Therapye/winter-practice/STL files/petal attachment.stl

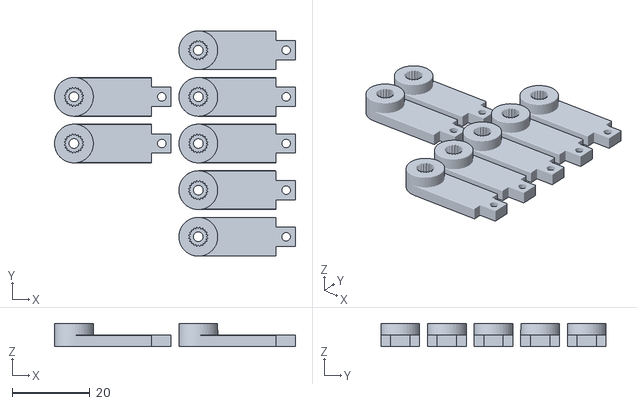
[picture p1: CAD file, 2026-03-15]
STL files/petal attachment.stl
62.0 x 58.0 x 6.00
