Therapye/winter-practice/STL files/petals.stl

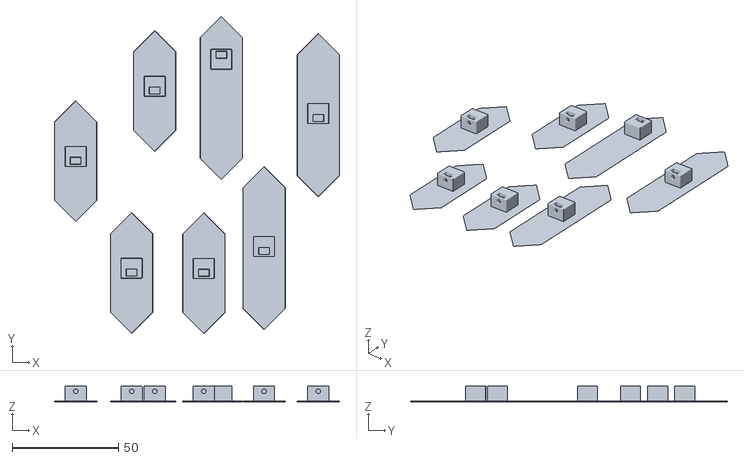
[picture p2: CAD file, 2026-03-15]
STL files/petals.stl
134.3 x 149.4 x 7.50
