Therapye/winter-practice/STL files/cover.stl

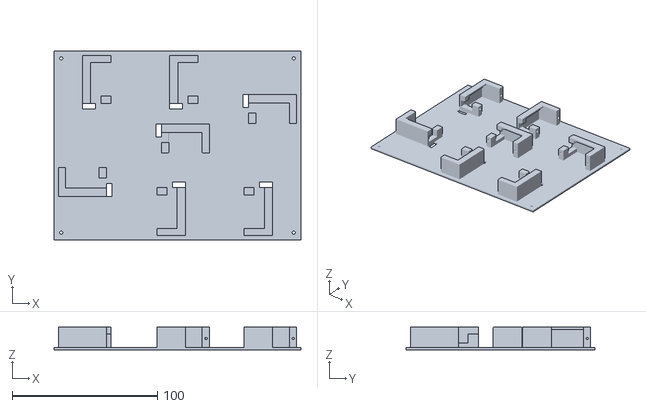
[picture p3: CAD file, 2026-03-15]
STL files/cover.stl
170.0 x 130.0 x 15.5
