Therapye/winter-practice/STL files/button cover.stl

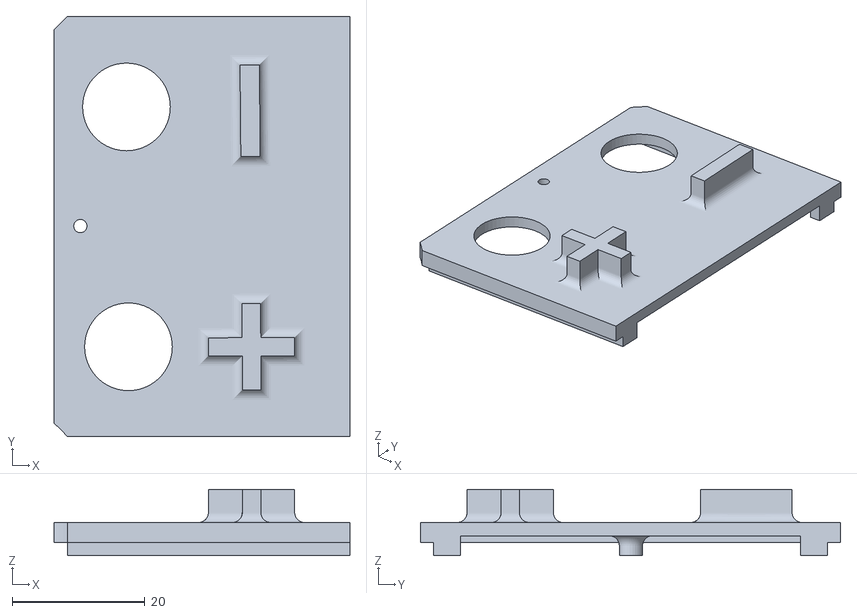
[picture p4: CAD file, 2026-03-15]
STL files/button cover.stl
44.6 x 63.3 x 10.0
