Therapye/winter-practice/STL files/bottom.stl

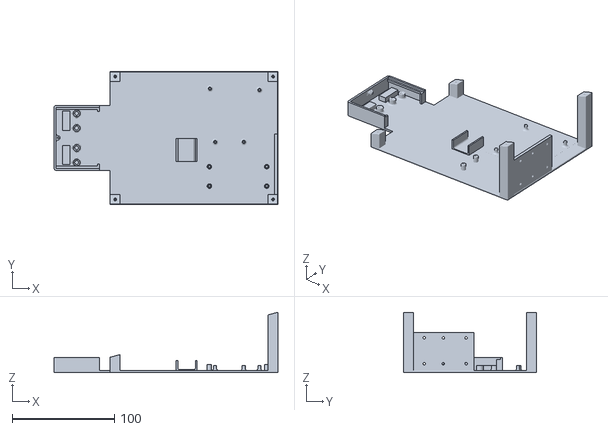
[picture p5: CAD file, 2026-03-15]
STL files/bottom.stl
218.8 x 130.0 x 59.0
