Therapye/winter-practice/Schematics/circuit for practise.kicad_sch

## KiCad design Schematics/circuit for practise.kicad_sch (2026-03-15)

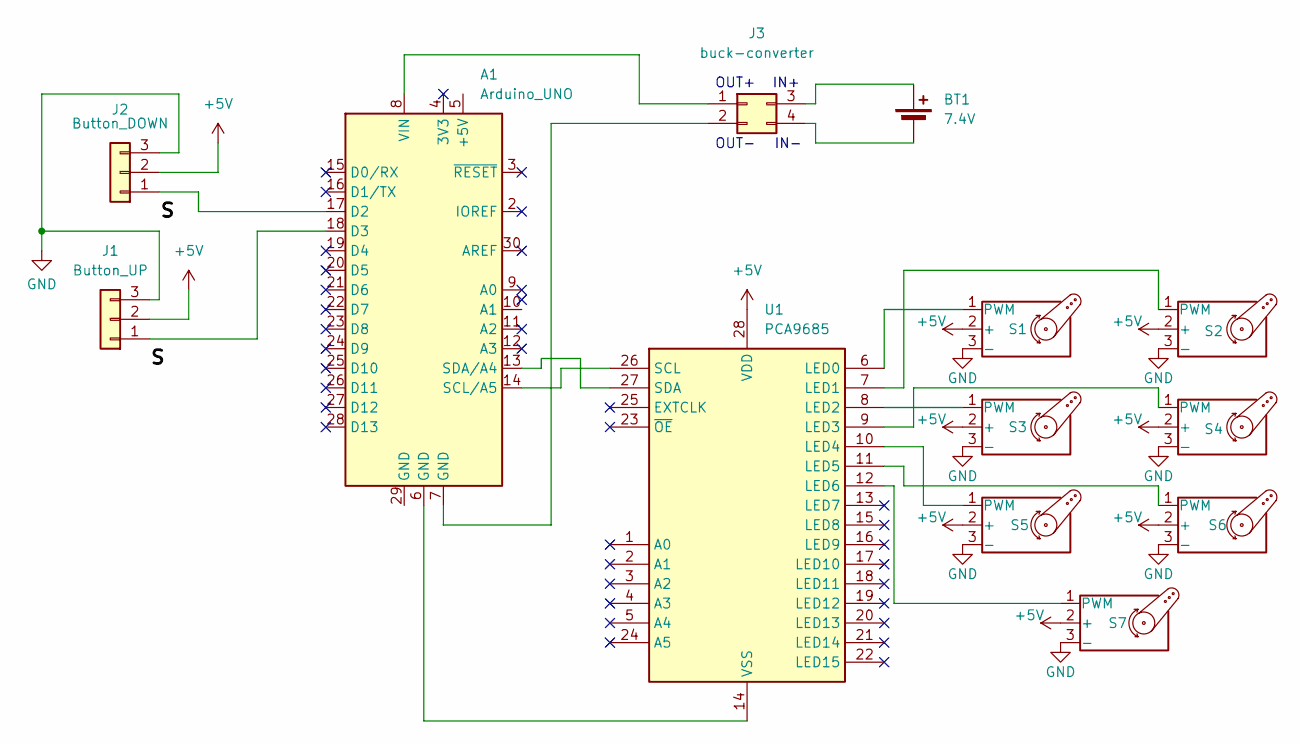
[picture p6: schematic circuit for practise.kicad_sch]

Parts:
A1: Arduino_UNO; Arduino_UNO_R2
BT1: 7.4V
J1: Button_UP
J2: Button_DOWN
J3: buck-converter
S1, S2, S3, S4, S5, S6, S7: Motor_Servo
U1: PCA9685; TSSOP-28_4.4x9.7mm_P0.65mm

Connections:
+5V: J1.2, J2.2, S1.2 (+), S2.2 (+), S3.2 (+), S4.2 (+), S5.2 (+), S6.2 (+), S7.2 (+), U1.28 (VDD)
GND: J1.3, J2.3, S1.3 (-), S2.3 (-), S3.3 (-), S4.3 (-), S5.3 (-), S6.3 (-), S7.3 (-)
unnamed: A1.6 (GND), U1.14 (VSS)
unnamed: A1.7 (GND), J3.2
unnamed: A1.8 (VIN), J3.1
unnamed: A1.13 (SDA/A4), U1.27 (SDA)
unnamed: A1.14 (SCL/A5), U1.26 (SCL)
unnamed: A1.17 (D2), J2.1
unnamed: A1.18 (D3), J1.1
unnamed: BT1.1 (+), J3.3
unnamed: BT1.2 (-), J3.4
unnamed: S1.1 (PWM), U1.6 (LED0)
unnamed: S2.1 (PWM), U1.7 (LED1)
unnamed: S3.1 (PWM), U1.8 (LED2)
unnamed: S4.1 (PWM), U1.9 (LED3)
unnamed: S5.1 (PWM), U1.10 (LED4)
unnamed: S6.1 (PWM), U1.11 (LED5)
unnamed: S7.1 (PWM), U1.12 (LED6)

Notes on the sheet:
OUT+
IN+
OUT-
IN-
